RISE-Software-Team/Tina_V2/drone_test_results/drone_test_3.csv

seq | timestamp | acc_x | acc_y | acc_z | gyro_x | gyro_y | gyro_z | pressure | altitude | fsm_state | fsm_state_str
11268 | 414766 | -94 | -68 | -951 | -7 | 13 | 6 | 10128 | 1 | 0 | FLIGHT_STATE_PREFLIGHT
11269 | 414802 | -88 | -60 | -957 | 0 | 2 | 0 | 10127 | 1 | 0 | FLIGHT_STATE_PREFLIGHT
11270 | 414838 | -78 | -38 | -964 | 0 | 0 | 0 | 10127 | 1 | 0 | FLIGHT_STATE_PREFLIGHT
11271 | 414875 | -86 | -51 | -959 | -1 | 1 | 0 | 10128 | 1 | 0 | FLIGHT_STATE_PREFLIGHT
11272 | 414911 | -82 | -50 | -959 | 0 | -1 | 0 | 10129 | 1 | 0 | FLIGHT_STATE_PREFLIGHT
11273 | 414948 | -75 | -43 | -962 | 0 | 0 | 0 | 10129 | 0 | 0 | FLIGHT_STATE_PREFLIGHT
11274 | 414984 | -80 | -45 | -960 | 0 | 0 | 0 | 10129 | 0 | 0 | FLIGHT_STATE_PREFLIGHT
11275 | 415020 | -78 | -47 | -960 | 0 | 0 | 0 | 10129 | 0 | 0 | FLIGHT_STATE_PREFLIGHT
11276 | 415057 | -78 | -47 | -962 | 0 | 0 | 0 | 10129 | 0 | 0 | FLIGHT_STATE_PREFLIGHT
11277 | 415093 | -74 | -43 | -967 | 0 | 0 | 0 | 10129 | 0 | 0 | FLIGHT_STATE_PREFLIGHT
11278 | 415130 | -80 | -45 | -959 | 0 | 0 | 0 | 10129 | 0 | 0 | FLIGHT_STATE_PREFLIGHT
11279 | 415166 | -76 | -41 | -963 | 0 | 0 | 0 | 10129 | 0 | 0 | FLIGHT_STATE_PREFLIGHT
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
