RISE-Software-Team/Tina_V2/drone_test_results/drone_test_2.csv

seq | timestamp | acc_x | acc_y | acc_z | gyro_x | gyro_y | gyro_z | pressure | altitude | fsm_state | fsm_state_str
6 | 3805 | 99 | 105 | -858 | 4 | -1 | 68 | 1014 | 0 | 0 | FLIGHT_STATE_PREFLIGHT
7 | 3836 | -50 | -20 | -1006 | -20 | 24 | 67 | 1014 | 0 | 0 | FLIGHT_STATE_PREFLIGHT
8 | 3868 | 111 | -218 | -922 | -7 | -5 | 41 | 1014 | 0 | 0 | FLIGHT_STATE_PREFLIGHT
9 | 3898 | 7 | -51 | -958 | 9 | -2 | 19 | 1014 | 0 | 0 | FLIGHT_STATE_PREFLIGHT
10 | 3928 | -45 | 0 | -993 | -3 | 0 | 2 | 1014 | 0 | 0 | FLIGHT_STATE_PREFLIGHT
11 | 3959 | 45 | -75 | -938 | -11 | -2 | 1 | 1014 | 0 | 0 | FLIGHT_STATE_PREFLIGHT
12 | 3989 | 24 | -64 | -960 | -1 | 0 | 2 | 1014 | 0 | 0 | FLIGHT_STATE_PREFLIGHT
13 | 4025 | -2 | -30 | -967 | 1 | 0 | 9 | 1014 | 0 | 0 | FLIGHT_STATE_PREFLIGHT
14 | 4061 | 7 | -18 | -949 | 1 | 0 | 17 | 1014 | 0 | 0 | FLIGHT_STATE_PREFLIGHT
15 | 4098 | 7 | -37 | -958 | 1 | 0 | 31 | 1014 | 0 | 0 | FLIGHT_STATE_PREFLIGHT
16 | 4135 | 1 | 6 | -956 | 1 | 0 | 43 | 1014 | 0 | 0 | FLIGHT_STATE_PREFLIGHT
17 | 4171 | 23 | -67 | -935 | 2 | -2 | 48 | 1014 | 0 | 0 | FLIGHT_STATE_PREFLIGHT
18 | 4207 | 10 | -142 | -977 | -4 | -2 | 33 | 1014 | 0 | 0 | FLIGHT_STATE_PREFLIGHT
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
