RISE-Software-Team/Tina_V2/drone_test_results/drone_test_1.csv

seq | timestamp | acc_x | acc_y | acc_z | gyro_x | gyro_y | gyro_z | pressure | altitude | fsm_state | fsm_state_str
429 | 19399 | 18 | 48 | -1084 | 1 | 25 | 52 | 1016 | 0 | 0 | FLIGHT_STATE_PREFLIGHT
430 | 19435 | -31 | 145 | -1027 | -5 | 12 | 38 | 1016 | 0 | 0 | FLIGHT_STATE_PREFLIGHT
431 | 19472 | -14 | 65 | -1032 | 6 | 0 | 33 | 1016 | 0 | 0 | FLIGHT_STATE_PREFLIGHT
432 | 19509 | 46 | 0 | -1034 | 70 | -2 | 25 | 1016 | 0 | 0 | FLIGHT_STATE_PREFLIGHT
433 | 19546 | -44 | 94 | -983 | 103 | -4 | 24 | 1016 | 0 | 0 | FLIGHT_STATE_PREFLIGHT
434 | 19583 | 32 | 1 | -889 | 27 | -26 | -18 | 1016 | 0 | 0 | FLIGHT_STATE_PREFLIGHT
435 | 19620 | -17 | 135 | -1087 | 70 | -31 | -10 | 1016 | 0 | 0 | FLIGHT_STATE_PREFLIGHT
436 | 19657 | 31 | 155 | -1180 | 84 | -46 | 8 | 1016 | 0 | 0 | FLIGHT_STATE_PREFLIGHT
437 | 19694 | 58 | 231 | -929 | 83 | -62 | 28 | 1016 | 0 | 0 | FLIGHT_STATE_PREFLIGHT
438 | 19731 | 109 | 289 | -1004 | 44 | -67 | 34 | 1016 | 1 | 0 | FLIGHT_STATE_PREFLIGHT
439 | 19769 | 182 | 273 | -1070 | 11 | -55 | 36 | 1016 | 2 | 0 | FLIGHT_STATE_PREFLIGHT
440 | 19806 | 144 | 182 | -910 | 18 | -23 | 30 | 1016 | 4 | 0 | FLIGHT_STATE_PREFLIGHT
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
