RISE-Software-Team/Tina_V2/Tina_PyroBoard/Core/Src/main.c

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
/* Includes ------------------------------------------------------------------*/
#include "main.h"

/* USER CODE BEGIN Includes */
#include "pyro_fsm.h"
/* USER CODE END Includes */

I2C_HandleTypeDef hi2c1;

UART_HandleTypeDef huart2;

void SystemClock_Config(void);
static void MX_GPIO_Init(void);
static void MX_USART2_UART_Init(void);
static void MX_I2C1_Init(void);
/**
  * @brief  The application entry point.
  * @retval int
  */
int main(void)
{

  /* MCU Configuration--------------------------------------------------------*/

  /* Reset of all peripherals, Initializes the Flash interface and the Systick. */
  HAL_Init();

  /* Configure the system clock */
  SystemClock_Config();

  /* Initialize all configured peripherals */
  MX_GPIO_Init();
  MX_USART2_UART_Init();
  MX_I2C1_Init();
  /* USER CODE BEGIN 2 */

//  HAL_I2C_Slave_Receive_IT(&hi2c1, rx_buffer, 2);




  uint8_t rx_buffer[2];
  uint8_t tx_buffer[2] = {0xFF, 0xFF};
  /* USER CODE END 0 */

  /* USER CODE END 2 */

  /* Infinite loop */
  /* USER CODE BEGIN WHILE */
  while (1)
  {
	    if (HAL_I2C_Slave_Receive(&hi2c1, rx_buffer, sizeof(rx_buffer), HAL_MAX_DELAY) == HAL_OK)
	    {
	        HAL_GPIO_TogglePin(GPIOB, GPIO_PIN_3);

	        CommandPacket_t packet;
			  packet.cmd = rx_buffer[0];
			  packet.param = rx_buffer[1];

			  pyro_handle_command(&packet, tx_buffer);


	        HAL_I2C_Slave_Transmit(&hi2c1, tx_buffer, sizeof(tx_buffer), HAL_MAX_DELAY);

	        HAL_Delay(1);
	    }
    /* USER CODE END WHILE */

    /* USER CODE BEGIN 3 */
  }
  /* USER CODE END 3 */
}

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
/* USER CODE BEGIN 4 */
//void HAL_I2C_SlaveRxCpltCallback(I2C_HandleTypeDef *hi2c)
//{
//    CommandPacket_t packet;
//    packet.cmd = rx_buffer[0];
//    packet.param = rx_buffer[1];
//
//    pyro_handle_command(&packet, tx_buffer);
//
//    HAL_I2C_Slave_Transmit_IT(&hi2c1, tx_buffer, 2);
//
//    HAL_I2C_Slave_Receive_IT(&hi2c1, rx_buffer, 2);
//}
//

/* USER CODE END 4 */
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
