RISE-Software-Team/Tina_V2/Tina_v2/Tina_v2.ioc

Mcu.UserName=STM32WLE5JCIx
PA0.GPIO_Label=DBG1
PA0.Signal=GPIO_Output
PA13.Signal=DEBUG_JTMS-SWDIO
PA14.Signal=DEBUG_JTCK-SWCLK
PA15.Signal=I2C2_SDA
PA2.Signal=USART2_TX
PA5.GPIO_Label=RF_CTRL2
PA5.Signal=GPIO_Output
PB0-VDD_TCXO.Signal=VDDTCXO
PB10.GPIO_Label=DBG2
PB10.Signal=GPIO_Output
PB13.GPIO_Label=BUT1
PB13.Signal=GPXTI13
PB15.Signal=I2C2_SCL
PB3.GPIO_Label=DBG3
PB3.Signal=GPIO_Output
PB4.GPIO_Label=DBG4
PB4.Signal=GPIO_Output
PB5.GPIO_Label=LED2
PB5.Signal=GPIO_Output
PB6.Signal=USART1_TX
PB7.Signal=USART1_RX
PC1.Signal=I2S2_SD
PC14-OSC32_IN.Signal=RCC_OSC32_IN
PC15-OSC32_OUT.Signal=RCC_OSC32_OUT
