RISE-Software-Team/Tina_V2/Tina_v2/App_Tina/FSM/flight_fsm.c

#include "flight_fsm.h"

#include "config.h"
#include "lang.h"
#include "logger.h"
#include "pyro_manager.h"
#include "telemetry.h"

#include <float.h>
#include <math.h>
#include <stdio.h>
#include <string.h>

#define DIFF_C_K 273.15f

/*******************************************************************************
 ****************************** Private functions ******************************
 *******************************************************************************/
static void transition_state(FlightFSM_t *fsm, FlightState_t new_state);
static float compute_average_value_from_history(float *hist);
static float compute_altitude(float pres, float ground_pres, float ground_temp);

static void update_data(FlightFSM_t *fsm);

/* Detection functions */
static bool launch_detected(FlightFSM_t *fsm);
static bool apogee_detected(FlightFSM_t *fsm);
static bool main_altitude_reached(FlightFSM_t *fsm);

/* Pyro helper functions*/
static void fire_drogue_and_transition(FlightFSM_t *fsm, uint32_t log_code);
static void fire_main_and_transition(FlightFSM_t *fsm, uint32_t log_code);

/* State handler functions */
static void handle_preflight(FlightFSM_t *fsm);
static void handle_powered_ascent(FlightFSM_t *fsm);
static void handle_drogue_descent(FlightFSM_t *fsm);
static void handle_main_descent(FlightFSM_t *fsm);
static void handle_error(FlightFSM_t *fsm);

/*******************************************************************************
 ******************************* Public functions ******************************
 *******************************************************************************/
const char *flight_fsm_get_state_name(FlightState_t state)
{
    switch (state) {
    case FLIGHT_STATE_PREFLIGHT:        return "PREFLIGHT";
    case FLIGHT_STATE_POWERED_ASCENT:   return "POWERED_ASCENT";
    case FLIGHT_STATE_DROGUE_DESCENT:   return "DROGUE_DESCENT";
    case FLIGHT_STATE_MAIN_DESCENT:     return "MAIN_DESCENT";
    case FLIGHT_STATE_ERROR:            return "ERROR";
    default:                            return "UNKNOWN";
    }
}

void flight_fsm_init(FlightFSM_t *fsm, bool pyro_armed)
{
    if (!fsm)
        return;

    memset(fsm, 0, sizeof(FlightFSM_t));

    fsm->state = FLIGHT_STATE_PREFLIGHT;
    fsm->state_entry_time_ms = HAL_GetTick();
    fsm->handler = handle_preflight;

    fsm->status.pyro_armed = pyro_armed;

    fsm->ground_temp_k = FLT_MAX;
    fsm->ground_pres_pa = FLT_MAX;
    fsm->min_pres_pa = FLT_MAX;

    tlog(INFO_FSM_INIT_PASS, NULL);
}

void flight_fsm_update(FlightFSM_t *fsm)
{
    if (!fsm || !fsm->handler)
        return;

    update_data(fsm);
    telemetry_send(fsm);
    fsm->handler(fsm);
}

static void transition_state(FlightFSM_t *fsm, FlightState_t new_state)
{
    if (fsm->state == new_state)
        return;

    int8_t log_code = INFO_DEBUG;

    switch (new_state) {
    case FLIGHT_STATE_PREFLIGHT:
        fsm->handler = handle_preflight;
        log_code = INFO_ENTERED_PREFLIGHT_STAGE;
        break;
    case FLIGHT_STATE_POWERED_ASCENT:
        fsm->handler = handle_powered_ascent;
        log_code = INFO_ENTERED_POWERED_ASCENT_STAGE;
        break;
    case FLIGHT_STATE_DROGUE_DESCENT:
        fsm->handler = handle_drogue_descent;
        log_code = INFO_ENTERED_DROGUE_DESCENT_STAGE;
        break;
    case FLIGHT_STATE_MAIN_DESCENT:
        fsm->handler = handle_main_descent;
        log_code = INFO_ENTERED_MAIN_DESCENT_STAGE;
        break;
    case FLIGHT_STATE_ERROR:
        fsm->handler = handle_error;
        log_code = ERR_FSM_STATE_FAIL;
        break;
    default:
        return;
    }

    fsm->state_entry_time_ms = HAL_GetTick();

    char log_msg[MAX_LOG_MESSAGE_LEN];
    snprintf(log_msg, sizeof(log_msg), "State transition: %u -> %u", fsm->state, new_state);
    tlog(log_code, log_msg);

    fsm->state = new_state;
}

static float compute_average_value_from_history(float *hist)
{
	float avg_val = 0;
	for (uint8_t i = 0; i < HISTORY_SIZE; i++)
		avg_val += hist[i];
	return avg_val / HISTORY_SIZE;
}

static float compute_altitude(float pres, float ground_pres, float ground_temp)
{

    static const float R_CONST = 287.052874f;
    static const float G_CONST = 9.80665f;
    static const float L_RATE  = 0.0065f;
    static const float ALPHA   = (R_CONST * L_RATE) / G_CONST;

    return (ground_temp / L_RATE) * (1.0 - pow(pres / ground_pres, ALPHA));
}

static void update_data(FlightFSM_t *fsm)
{
	if (!fsm)
		return;

    int8_t ret = sensors_read_all(&fsm->sensor_data);
    switch (ret) {
    case 0:
    	fsm->status.baro_ok = true;
    	fsm->status.imu_ok = true;
    	break;
    case -1:
    	fsm->status.baro_ok = false;
    	fsm->status.imu_ok = true;
    	break;
    case -2:
    	fsm->status.baro_ok = true;
    	fsm->status.imu_ok = false;
    	break;
    default:
    	fsm->status.baro_ok = false;
    	fsm->status.imu_ok = false;
    }

    if (fsm->status.baro_ok) {
        if (fsm->ground_temp_k == FLT_MAX) {
            fsm->ground_temp_k = fsm->sensor_data.temp + DIFF_C_K;
    		fsm->ground_pres_pa = fsm->sensor_data.pres;

            for (uint8_t i = 0; i < HISTORY_SIZE; i++)
                fsm->hist.pres[i] = fsm->sensor_data.pres;

            tlog(INFO_GROUND_PRES_AND_TEMP_SET, NULL);
    	}

        fsm->hist.pres[fsm->hist.pres_index] = fsm->sensor_data.pres;
        fsm->hist.pres_index = (fsm->hist.pres_index + 1) % HISTORY_SIZE;
        fsm->hist.avg_pres = compute_average_value_from_history(fsm->hist.pres);
        fsm->hist.avg_alt = compute_altitude(fsm->hist.avg_pres, fsm->ground_pres_pa, fsm->ground_temp_k);

        fsm->min_pres_pa = min(fsm->min_pres_pa, fsm->hist.avg_pres);
    }

    if (fsm->status.imu_ok) {
        if (fsm->hist.avg_vert_acc == 0 && fsm->hist.vert_acc_index == 0) {
            fsm->hist.avg_vert_acc = fsm->sensor_data.acc_z;

            for (uint8_t i = 0; i < HISTORY_SIZE; i++)
                fsm->hist.vert_acc[i] = fsm->sensor_data.acc_z;
        } else {
            fsm->hist.vert_acc[fsm->hist.vert_acc_index] = fsm->sensor_data.acc_z;
            fsm->hist.vert_acc_index = (fsm->hist.vert_acc_index + 1) % HISTORY_SIZE;
            fsm->hist.avg_vert_acc = compute_average_value_from_history(fsm->hist.vert_acc);
        }
    }

}

static bool launch_detected(FlightFSM_t *fsm)
{
    if (!fsm)
        return false;

    if (fsm->status.imu_ok && fsm->hist.avg_vert_acc > LAUNCH_ACCEL_THRESHOLD_MS2){

        tlog(INFO_LAUNCH_DETECTED_FROM_ACCELERATION, NULL);
    	return true;
    }

    if (fsm->status.baro_ok && fsm->hist.avg_alt > LAUNCH_ALTITUDE_THRESHOLD_M){
        tlog(INFO_LAUNCH_DETECTED_FROM_ALTITUDE, NULL);
    	return true;
    }

    return false;
}

/* Apogee is detected if the average pressure from history is
 * higher than the minimum pressure. */
static bool apogee_detected(FlightFSM_t *fsm)
{
    if (!fsm)
        return false;

    bool rising_pressure = false;

    if (fsm->status.baro_ok && fsm->hist.avg_pres > fsm->min_pres_pa + DELTA_PRESSURE_FOR_APOGEE_DETECTION_PA)
    	rising_pressure  = true;

    static int8_t apogee_countdown = APOGEE_COUNTDOWN_SIZE;

    if (rising_pressure) {
    	apogee_countdown = max(apogee_countdown - 1, 0);
    } else {
    	apogee_countdown = APOGEE_COUNTDOWN_SIZE;
    }

    return apogee_countdown == 0;
}

static bool main_altitude_reached(FlightFSM_t *fsm)
{
    if (!fsm)
    	return false;

    if (fsm->status.baro_ok && fsm->hist.avg_alt < MAIN_DEPLOY_ALTITUDE_M)
    	return true;

    return false;
}

static void fire_drogue_and_transition(FlightFSM_t *fsm, uint32_t log_code)
{
    uint8_t drogue_response[2];
    int8_t status;

    status = deploy_parachute(DROGUE, drogue_response);

    if (status != 0) {
        tlog(ERR_PYRO_DROGUE_FAIL, "Drogue deployment failed");
        // TODO: Decide what to do here? maybe fire main? ask chiefs
        // transition_state(fsm, FLIGHT_STATE_ERROR);
        return;
    }

    fsm->status.drogue_fired = true;
    tlog(log_code, NULL);

    transition_state(fsm, FLIGHT_STATE_DROGUE_DESCENT);
}

static void fire_main_and_transition(FlightFSM_t *fsm, uint32_t log_code)
{
    uint8_t main_response[2];
    int8_t status;

    status = deploy_parachute(MAIN, main_response);

    if (status != 0) {
        tlog(ERR_PYRO_MAIN_FAIL, "Main deployment failed");
        //TODO decide what to do here?
        // transition_state(fsm, FLIGHT_STATE_ERROR);
        // return;
    }

    fsm->status.main_fired = true;
    tlog(log_code, NULL);

    transition_state(fsm, FLIGHT_STATE_MAIN_DESCENT);
}

static void handle_preflight(FlightFSM_t *fsm)
{
    if (!fsm)
        return;

    if (launch_detected(fsm))
        transition_state(fsm, FLIGHT_STATE_POWERED_ASCENT);
}

static void handle_powered_ascent(FlightFSM_t *fsm)
{
    if(!fsm)
        return;

    if (apogee_detected(fsm)) {
        fire_drogue_and_transition(fsm, INFO_DROGUE_PARACHUTE_DEPLOYED);
        return;
    }

    if (HAL_GetTick() - fsm->state_entry_time_ms > LAUNCH_TO_APOGEE_TIMEOUT_MS)
        fire_drogue_and_transition(fsm, INFO_DROGUE_PARACHUTE_DEPLOYED_TIMEOUT);
}

static void handle_drogue_descent(FlightFSM_t *fsm)
{
    if (!fsm)
        return;

    if (main_altitude_reached(fsm)) {
        fire_main_and_transition(fsm, INFO_MAIN_PARACHUTE_DEPLOYED);
        return;
    }

    if (HAL_GetTick() - fsm->state_entry_time_ms > APOGEE_TO_MAIN_TIMEOUT_MS)
        fire_main_and_transition(fsm, INFO_MAIN_PARACHUTE_DEPLOYED_TIMEOUT);
}

static void handle_main_descent(FlightFSM_t *fsm)
{
    /* Nothing to do */
}

static void handle_error(FlightFSM_t *fsm)
{
    tlog(ERR_FSM_STATE_FAIL, NULL);
}
