RISE-Software-Team/Tina_V2/Tina_PyroBoard/Core/Inc/main.h

#define MCO_Pin GPIO_PIN_0
#define MCO_GPIO_Port GPIOF
#define VCP_TX_Pin GPIO_PIN_2
#define VCP_TX_GPIO_Port GPIOA
#define En_Pyro_1_Pin GPIO_PIN_3
#define En_Pyro_1_GPIO_Port GPIOA
#define En_Pyro_2_Pin GPIO_PIN_4
#define En_Pyro_2_GPIO_Port GPIOA
#define En_Pyro_3_Pin GPIO_PIN_5
#define En_Pyro_3_GPIO_Port GPIOA
#define En_Pyro_4_Pin GPIO_PIN_6
#define En_Pyro_4_GPIO_Port GPIOA
#define Pyro_Read_4_Pin GPIO_PIN_1
#define Pyro_Read_4_GPIO_Port GPIOB
#define Pyro_Read_3_Pin GPIO_PIN_8
#define Pyro_Read_3_GPIO_Port GPIOA
#define SWDIO_Pin GPIO_PIN_13
#define SWDIO_GPIO_Port GPIOA
#define SWCLK_Pin GPIO_PIN_14
#define SWCLK_GPIO_Port GPIOA
#define VCP_RX_Pin GPIO_PIN_15
#define VCP_RX_GPIO_Port GPIOA
#define Pyro_Read_1_Pin GPIO_PIN_4
#define Pyro_Read_1_GPIO_Port GPIOB
#define Pyro_Read_2_Pin GPIO_PIN_5
#define Pyro_Read_2_GPIO_Port GPIOB
