RISE-Software-Team/Tina_V2/Tina_v2/App_Tina/Sensors/BME280/bme280_mock_driver.c

#include "bme280_api.h"

/* -------------------------------------------------------------------------- */
/* Base Values                                                                */
/* -------------------------------------------------------------------------- */
static float BASE_TEMP  = 25.0f;
static float BASE_PRESS = 1000.0f;
static float BASE_HUM   = 50.0f;

static float add_random_noise(float base, float range)
{
    // range = ±range (so range=1 gives random change between -1 and +1)
    float noise = ((float)(rand() % 2001) / 1000.0f - 1.0f) * range;
    return base + noise;
}


/* -------------------------------------------------------------------------- */
/* Mock-level operations                                                  */
/* -------------------------------------------------------------------------- */
static int32_t mock_init(void);
static int mock_read_all(float *temp, float *press, float *hum);
static int mock_read_temperature(float *temp);
static int mock_read_pressure(float *press);
static int mock_read_humidity(float *hum);

/* -------------------------------------------------------------------------- */
/* Default hardware driver instance                                           */
/* -------------------------------------------------------------------------- */
const BME280_Driver_t bme280_default_driver = {
    .init = mock_init,
    .read_temperature = mock_read_temperature,
    .read_pressure = mock_read_pressure,
    .read_humidity = mock_read_humidity,
    .read_all = mock_read_all,
};

/* -------------------------------------------------------------------------- */
/* Initialize BME280 hardware                                                 */
/* -------------------------------------------------------------------------- */
static int32_t mock_init(void)
{
    return 0;
}

static int mock_read_all(float *temp, float *press, float *hum)
{
    mock_read_temperature(temp);
    mock_read_pressure(press);
    mock_read_humidity(hum);
    return 0;
}

/* -------------------------------------------------------------------------- */
/* Individual sensor read wrappers                                            */
/* -------------------------------------------------------------------------- */
static int mock_read_temperature(float *temp) {
    *temp = add_random_noise(BASE_TEMP, 1.0f);
    return 0;
}

static int mock_read_pressure(float *press) {
    *press = add_random_noise(BASE_PRESS, 1.0f);
    return 0;
}

static int mock_read_humidity(float *hum) {
    *hum = add_random_noise(BASE_HUM, 1.0f);
    return 0;
}
