RISE-Software-Team/Tina_V2/Tina_v2/SubGHz_Phy/App/subghz_phy_app.h

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

/* Define to prevent recursive inclusion -------------------------------------*/
#ifndef __SUBGHZ_PHY_APP_H__
#define __SUBGHZ_PHY_APP_H__

#ifdef __cplusplus
extern "C" {
#endif

/* Includes ------------------------------------------------------------------*/
/* USER CODE BEGIN Includes */
#include "config.h"
#include "packet.h"

#include <stdint.h>

/* USER CODE END Includes */

/* Exported types ------------------------------------------------------------*/
/* USER CODE BEGIN EC */
#define TX_TIMEOUT_VALUE 							3000 // TODO find a suitable time for this
#define RX_TIMEOUT_VALUE              				3000
#define RF_FREQUENCY                                868000000 /* Hz  */
#define TX_OUTPUT_POWER                             14        /* dBm */
#define LORA_BANDWIDTH                              2         /* [0: 125 kHz, 1: 250 kHz, 2: 500 kHz, 3: Reserved] */
#define LORA_SPREADING_FACTOR                       7         /* [SF7..SF12] */
#define LORA_CODINGRATE                             1         /* [1: 4/5, 2: 4/6, 3: 4/7, 4: 4/8] */
#define LORA_PREAMBLE_LENGTH                        8         /* Same for Tx and Rx */
#define LORA_SYMBOL_TIMEOUT                         5         /* Symbols */
#define LORA_FIX_LENGTH_PAYLOAD_ON                  false
#define LORA_IQ_INVERSION_ON                        false


#define TX_QUEUE_SIZE 100


typedef struct {
    uint8_t payload[MAX_PACKET_LENGTH];
    uint8_t length;
} TxQueueItem_t;

typedef struct {
    TxQueueItem_t items[TX_QUEUE_SIZE];
    uint8_t head;
    uint8_t tail;
    uint8_t count;
} TxQueue_t;



/* USER CODE END EC */

/* External variables --------------------------------------------------------*/
/* Exported macros -----------------------------------------------------------*/
/* Exported functions prototypes ---------------------------------------------*/
/**
  * @brief  Init Subghz Application
  */
void SubghzApp_Init(void);

/* USER CODE BEGIN EFP */
void radio_send_packet(void);
void radio_send_telemetry_packet(TelemetryPacket_t telemetry);
void radio_send_log_packet(LogPacket_t log);
/* USER CODE END EFP */

#ifdef __cplusplus
}
#endif

#endif /*__SUBGHZ_PHY_APP_H__*/
