RISE-Software-Team/Tina_V2/Tina_v2/App_Tina/Sensors/BNO055/bno055_api_types.h

/*
 * bno055_api_types.h
 *
 *  Created on: Oct 22, 2025
 *      Author: pranavsuri4303
 */

#ifndef BNO055_API_TYPES_H
#define BNO055_API_TYPES_H

typedef struct {
    float x;  // m/s^2
    float y;
    float z;
} BNO055_AccelData_t;

typedef struct {
    float x;  // deg/s
    float y;
    float z;
} BNO055_GyroData_t;

#endif /* BNO055_API_TYPES_H */
