RISE-Software-Team/Tina_V2/Tina_v2/App_Tina/Utils/logger.h

/*
 * error_handler.h
 *
 *  Created on: Oct 7, 2025
 *      Author: krissal1234
 */

#ifndef UTILS_LOGGER_H_
#define UTILS_LOGGER_H_

typedef enum {
	// ---------- INFO CODES (positive) ----------
	INFO_DEBUG                             = 0,

	INFO_IMU_INIT_PASS                     = 1,
	INFO_BARO_INIT_PASS                    = 2,
	INFO_PYRO_ARM_PASS                     = 3,
	INFO_FSM_INIT_PASS                     = 4,

	INFO_COMPONENT_SANITY_CHECK_PASS       = 5,

	INFO_ENTERED_PREFLIGHT_STAGE           = 6,
	INFO_ENTERED_POWERED_ASCENT_STAGE      = 7,
	INFO_ENTERED_DROGUE_DESCENT_STAGE      = 8,
	INFO_ENTERED_MAIN_DESCENT_STAGE        = 9,

	INFO_DROGUE_PARACHUTE_DEPLOYED         = 10,
	INFO_MAIN_PARACHUTE_DEPLOYED           = 11,

	INFO_DROGUE_PARACHUTE_DEPLOYED_TIMEOUT = 12,
	INFO_MAIN_PARACHUTE_DEPLOYED_TIMEOUT   = 13,

	INFO_GROUND_PRES_AND_TEMP_SET          = 14,

	INFO_LAUNCH_DETECTED_FROM_ACCELERATION = 15,
	INFO_LAUNCH_DETECTED_FROM_ALTITUDE		 = 16,

    // ---------- ERROR CODES (negative) ----------
	ERR_COMPONENT_SANITY_CHECK_FAIL        = -1,

	ERR_IMU_INIT_FAIL                      = -2,   // BNO055 failure
	ERR_IMU_CALIB_FAIL                     = -3,
	ERR_IMU_READ_ACCEL_FAIL                = -4,
	ERR_IMU_READ_GYRO_FAIL                 = -5,

	ERR_BARO_INIT_FAIL                     = -6,   // BME280 failure
	ERR_BARO_CALIB_FAIL                    = -7,
	ERR_BARO_READ_FAIL                     = -8,

	ERR_PYRO_DROGUE_FAIL                   = -9,   // Pyro channel firing fault
	ERR_PYRO_MAIN_FAIL                     = -10,  // Pyro channel firing fault
	ERR_TIMEOUT_APOGEE                     = -11,  // Drogue deployment triggered by safety timeout

	ERR_I2C_LINE_FAIL                      = -12,

	ERR_FSM_STATE_FAIL                     = -13,  // FSM state went invalid
	ERR_MISC_ERR                           = -14,  // Undefined software exception

	ERR_PYRO_ARM_FAIL                      = -15,

	ERR_PYRO_SEND_COMMAND_FAIL             = -16,  // I2C TX to Pyro board failed
	ERR_PYRO_RECEIVE_COMMAND_FAIL          = -17,  // I2C RX from Pyro board failed
} MessageCode_t;


void tlog(MessageCode_t message_code, const char *msg);

#endif /* UTILS_LOGGER_H_ */
