RISE-Software-Team/Tina_V2/Tina_v2/App_Tina/Utils/types.h

#ifndef TYPES_H
#define TYPES_H

#include <stdbool.h>
#include <stdint.h>

typedef int8_t   s8;
typedef int16_t  s16;
typedef int32_t  s32;
typedef int64_t  s64;

typedef uint8_t  u8;
typedef uint16_t u16;
typedef uint32_t u32;
typedef uint64_t u64;

#endif /* TYPES_H_ */
