RISE-Software-Team/Tina_V2/(commit log)

2025-09-29 setup framework, configured pins based on pin map by electronics
2025-10-03 changed project to the STM chip of the lora module and flashed blink led code
2025-10-03 configured Lora module using sub_ghz and began writing driver, finsihed writing driver for telemetry packet, yet to test sending data over radio
2025-10-07 some modularisation and error handler
    [Tina_v2.ioc, error_handler.c, main.c, packet.c, packet.h, subghz_phy_app.c]
2025-10-08 created stmproject for sensor testing
2025-10-10 feat: add support for bno055 sensor
2025-10-12 pyro board configuration
2025-10-12 some testing on pyro board and it workd
2025-10-14 figured out bme280 issue, as it initilaised in sleep mode, also added queue based telemetry
    [main.c, packet.c, subghz_phy_app.c]
2025-10-15 feat: update .gitignore to include all stm32 projects
2025-10-16 fix: cleanup the radio queue
    [logger.c, packet.c, packet.h, subghz_phy_app.c, subghz_phy_app.h]
2025-10-18 feat: add priority based logging
    Log message code update:
    * changed order to something expected during execution
    (e.g. sanity check is the first log we should receive)
    * added different errors for imu read gyro and accel fails
    * left only one debug code (TLOG_DEBUG) and moved it to 0
    Currently, we send only one message per loop. The send is triggered
    by MX_SubGHz_Phy_Process. Therefore, if we average more than one log
    per loop, the radio queue will fill up and drop messages.
    Additionally, sending the same error or debug message every loop
    will clutter the logs with useless messages.
    To resolve the issue, we will limit the number of identical logs
    to one per second.
    [config.h, logger.c, logger.h, main.c, packet.h, packet_parser.py, subghz_phy_app.c, subghz_phy_app.h]
2025-10-18 fix: add missing return in logger
    [logger.c]
2025-10-22 Fix folder sttructure.
    Move sensors files into each individual folder.
    [bme280.c, bme280.h, bno055.h]
2025-10-22 add sensor folders in environment variables
2025-10-22 BME280
    - Update bme280.c to use BME280_ERROR instead of ERROR
    - Add mocking capability
    [bme280.c, bme280.h]
2025-10-22 increase sensor accuracy
2025-10-22 BME280 Structure changes
    - Add bme280_hw_driver file to seperate hardware driver implementatino
    - Change responsibility of bme280_api to handle which driver to user mock or hardware
    - Change oversampling for pressure to 16x
    - Add comments
2025-10-26 Update BME280 driver to use BME280_SUCCESS instead of SUCCESS
2025-10-26 Refactor BME280 driver API and hardware implementation
    Renamed default_driver to bme280_default_driver and updated references for clarity. Standardized integer types to int32_t in API and hardware driver. Added BME280_Data_t struct for sensor readings and removed unused external dependencies from API header.
2025-10-28 fix: cleanup the imu sensor
    * removed old support files
    * correctly initialize the sensor
    [bno055_hw_driver.c, main.c]
2025-10-28 added cleaned rocket simulation data, with cleaner py file, if more values are needed, they can be added in the py file
    [Simulation_2__Sustainer.csv, Simulation_3__Sustainer.csv, Simulation_5__Sustainer.csv]
2025-10-28 remove mock files from build process in stm32
2025-10-28 Update Readme.md with BME280 test output
    Added sample output for BME280 test in Readme.md
2025-10-29 fix: change new line detection to line feed
    [bno055.h, main.c, main.h]
2025-10-29 feat: add sensor read
    Added helper function that reads data from all sensors and aggregates
    it into a SensorData_t struct.
    I read only the data needed for our usecase.
    When sending telemetry over radio, we will convert the data from float
    to smaller integer numbers.
2025-10-29 feat: add telemetry send
    The function should be called from the main loop.
    It sends telemetry over the radio at a predefined time interval.
    Current time interval is 100 ms.
2025-10-29 feat: use sensors_read_all and telemetry_send in main
2025-10-29 feat: don't call register driver if default driver is used
    * initialized driver to the default one without the need to
    call register driver.
    * removed unnecessary get driver functions (driver is never null)
2025-10-29 fix: remove telemetry send error code
    [logger.c, logger.h, main.c]
2025-10-30 feat: add pressure and fsm state in telemetry packet
2025-10-30 fix: remove magic numbers from packet parser
    [packet_parser.py]
2025-10-30 feat: read temperature with sensors_read_all
2025-11-01 fix: change acceleration launch detection to acc_z
    [flight_fsm.c]
2025-11-01 fix: change telemetry pres and alt to signed integers
    [packet.h, packet_parser.py, telemetry.c]
2025-11-01 fix: set ground temp correctly
    [flight_fsm.c, packet_parser.py]
2025-11-03 fix: send -1 for pres and alt when sensor fails
    [telemetry.c]
2025-11-03 fix: invert acceleration z axis
    [bno055_hw_driver.c]
2025-11-03 feat: add complete fsm history
    * added history for vertical acceleration
    * added average values for pressure, altitude, and vertical acceleration
2025-11-03 fix: cleanup log message codes
    [flight_fsm.c, logger.c, logger.h, main.c, packet_parser.py, sensor.c]
2025-11-03 fix: remove sensors reinitialization from i2c fail handler
    [main.c]
2025-11-03 feat: add code for pyro board
2025-11-03 feat: complete power ascent and drogue descent handlers
    * fire parachutes
    * added backup timer for both drogue and main
2025-11-03 feat: arm pyro in main
2025-11-03 fix: correctly handle the arm pyro return code
    [main.c]
2025-11-03 fix: show telemetry on terminal again
    [packet_parser.py]
2025-11-04 removed logic for arm pyro
2025-11-05 added history pressure in min function, added delta for apogee detection
    [drone_test_2.csv]
2025-11-05 shifted by 1 pressure to send down
2025-11-06 changed pressure to int32
2025-11-06 more precise altitude
    [drone_test_3.csv]
2025-11-07 fix: move static variable inside the apogee function
    [flight_fsm.c]
2025-11-13 sending down filtered pres and acc_z
