RISE-Software-Team/Tina_V2/(notices)

Notices in the files:
Tina_v2/SubGHz_Phy/App/subghz_phy_app.c:
Copyright (c) 2025 STMicroelectronics.
All rights reserved.
This software is licensed under terms that can be found in the LICENSE file
